bao-zhao/EMetaNode/pcb/BOM.xlsx

Comment | Description | Designator | Footprint | LibRef | Quantity
680p |  | C1 | C0603 | C | 1
100uF |  | C2, C6, C7 | C1206 | 100uF | 3
10u |  | C3 | C0603 | C | 1
0.1u |  | C4, C5 | C0603 | C | 2
KH-2.54PH180-1X2P-L11.5 |  | Cr, Cr1, GND, Im, IR, Vem, Vo-, VS | HDR-TH_2P-P2.54-V-M | KH-2.54PH180-1X2P-L11.5 | 8
SS16A |  | D1, D2 | SMA_L4.4-W2.6-LS5.0-RD | SS16A | 2
ANTENNA-GROUNDEDTRACE-15.2MM |  | E1 | ANT-F-1-2.4G-1.0mmFR4-WCH | ANTENNA-GROUNDEDTRACE-15.2MM | 1
MB6S_C2487 |  | F1, F2 | MBS_L4.7-W3.8-P2.40-LS7.0-TL | MB6S_C2487 | 2
IN100-Q1-R-RC1I_C6062024 |  | IN1 | QFN-18_L3.0-W3.0-P0.40-TL-EP | IN100-Q1-R-RC1I_C6062024 | 1
PZ254V-11-06P |  | IOSW, UART | HDR-TH_6P-P2.54-V-M | PZ254V-11-06P | 2
Inductor | Inductor | L1 | Inductance | Inductor | 1
BSS159N H6327 |  | QD1 | PG-SOT23-3_L2.9-W1.3-P1.90-LS2.4-BR | BSS159N H6327 | 1
BSS123N H6327 |  | QN1 | PG-SOT23-3_L2.9-W1.3-P1.90-LS2.4-BR | BSS123N H6327 | 1
BC856B,215 |  | QP1 | SOT-23-3_L2.9-W1.6-P1.90-LS2.8-BR | BC856B,215 | 1
20M |  | R1, R6 | R0603 | R | 2
220K |  | R2 | R0603 | R | 1
100 |  | R3 | R0603 | R | 1
10M |  | R4, R7 | R0603 | R | 2
10k |  | R8 | R0603 | R | 1
100M |  | R_l | R0603 | R | 1
40M |  | R_s | R0603 | R | 1
PZ254V-11-03P_C2937625 |  | Rl/s | HDR-TH_3P-P2.54-V-M | PZ254V-11-03P_C2937625 | 1
TS342A2P-WZ |  | RST1 | SW-SMD_L4.0-W2.9-LS5.0 | TS342A2P-WZ | 1
XKB5858-Z |  | SEH/SECE | SW-TH_6P-L5.8-W5.8-P2.00-LS4.5-BR | XKB5858-Z | 1
ZXTD4591E6TA |  | T1 | SOT-23-6_L2.9-W1.6-P0.95-LS2.8-BR | ZXTD4591E6TA | 1
PZ254V-11-04P_C2691448 |  | VIN | HDR-TH_4P-P2.54-V-M | PZ254V-11-04P_C2691448 | 1
CN4026M00006BE840000 |  | X1 | CRYSTAL-SMD_4P-L2.0-W1.6-BL | CN4026M00006BE840000 | 1
