bao-zhao/EMetaNode/pcb/EMetaNode_Schematic.pdf

# EMetaNode

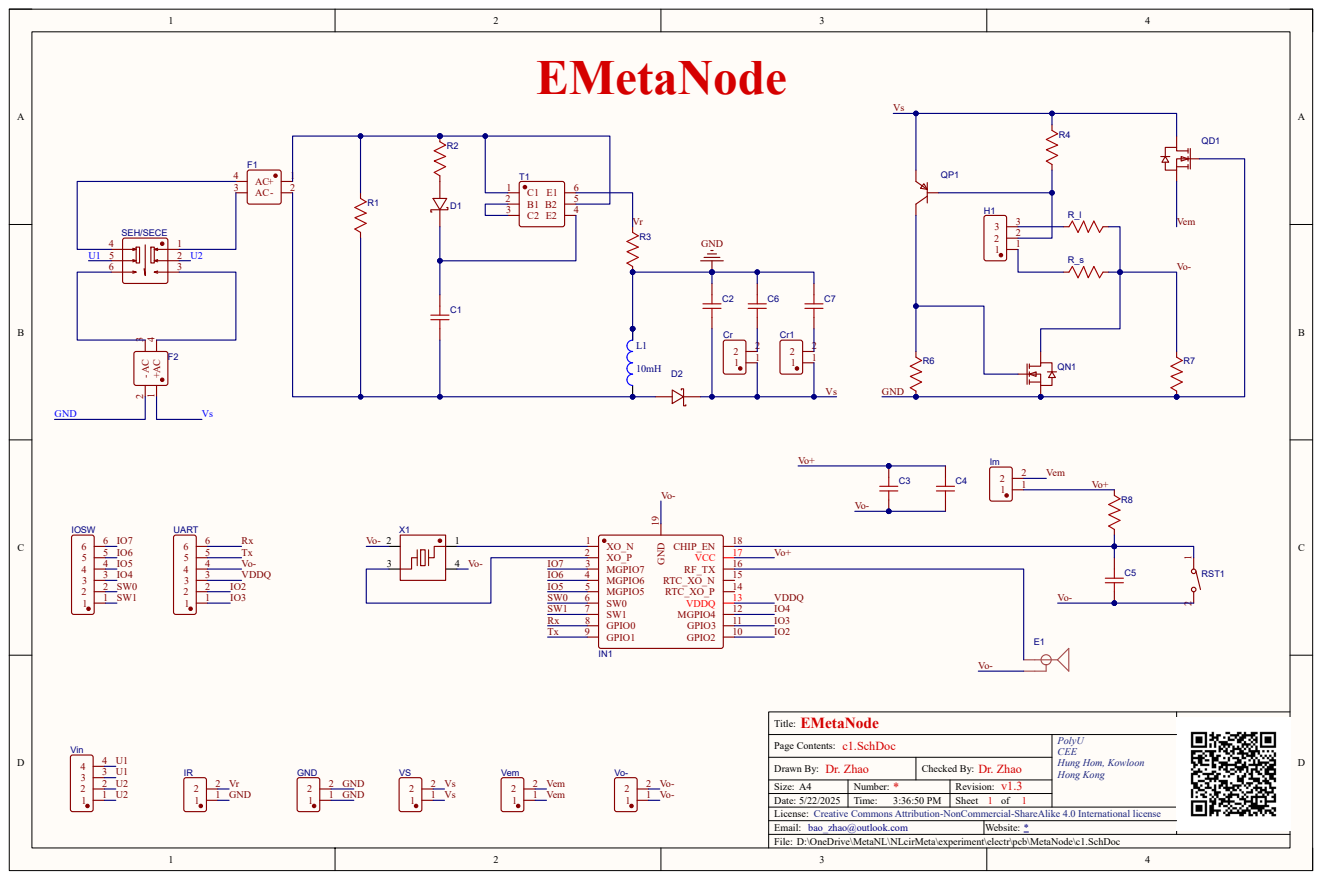
[picture p2: page 1]

Date:
License: Creative Commons Attribution-NonCommercial-ShareAlike 4.0 International license
Email: bao_zhao@outlook.com
File:
D:\OneDrive\MetaNL\NLcirMeta\experiment\electr\pcb\MetaNode\c1.SchDoc
