bao-zhao/EMetaNode/(commit log)

2025-05-22 Create Gerber_files
2025-05-22 Add files via upload
    on-chip temperature and external acceleration sensing
    [IN100_sensing.cfg]
2025-05-22 Update and rename IN100_sensing.cfg to codes/IN100_sensing.cfg
    [IN100_sensing.cfg]
2025-07-21 Create pcb
